arturo182/sama5d27c_breakout/(threads)

Thread 1 (2019-03-03):

USBC UFP termination resistors

limpkin, 2019-03-03:
Hello and congrats for the nice job!

Looking at https://community.cypress.com/docs/DOC-10779 it seems your 5.1k should be attached to GND and not +3.3V, do you agree?

arturo182, 2019-03-07:
Yes, I had it wrong all this time :D

Since the board is sinking current, the pulls should be connected to GND.

Good catch!

limpkin, 2019-03-07:
thanks for the footprint!
