arturo182/sama5d27c_breakout/sama5d27c_breakout.pdf

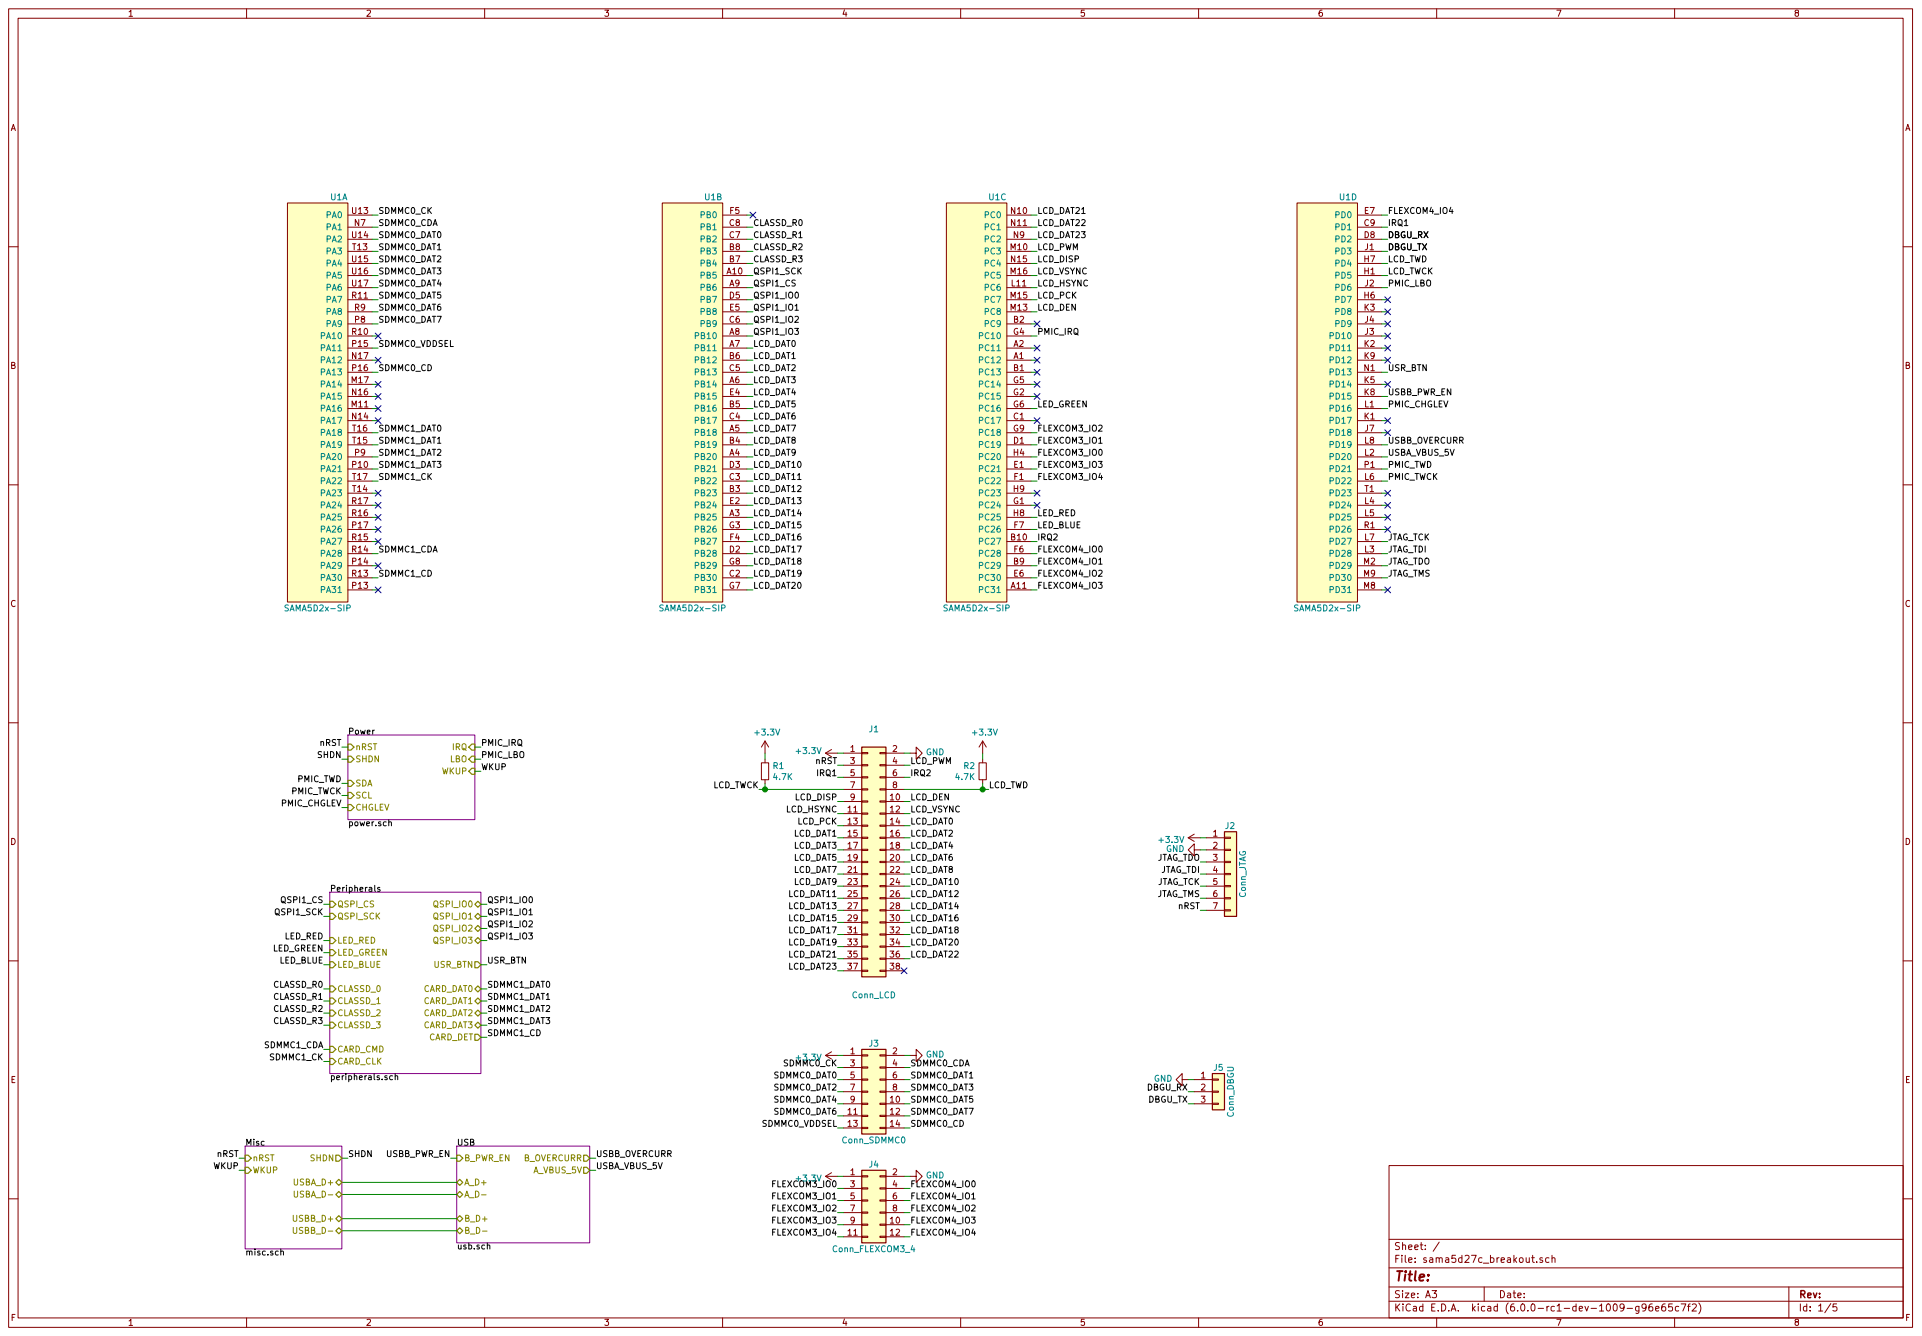
[picture p1: page 1]

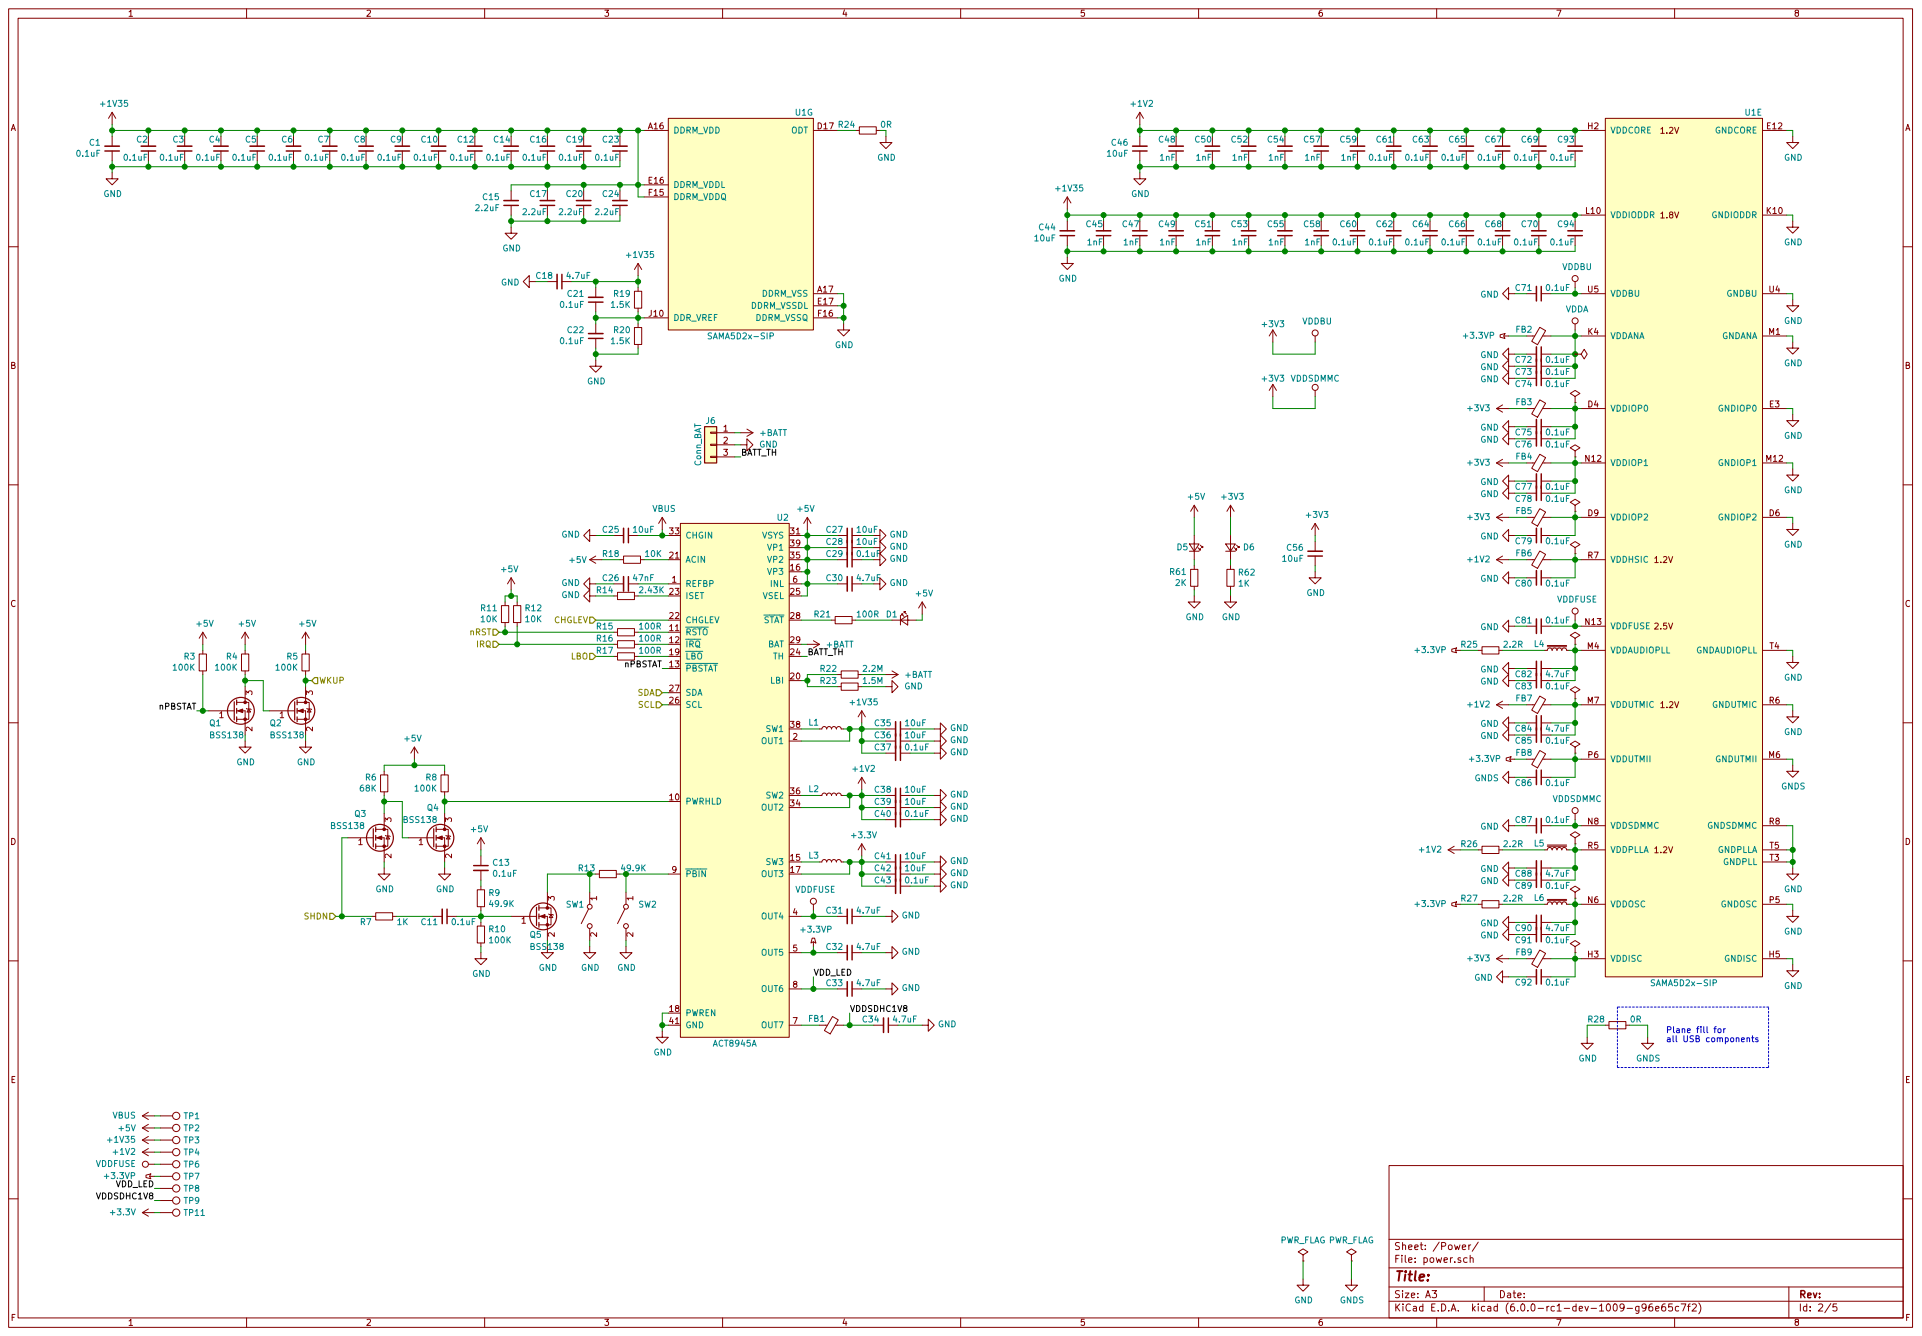
[picture p2: page 2]

Plane fill for all USB components

File: power.sch Sheet: /Power/

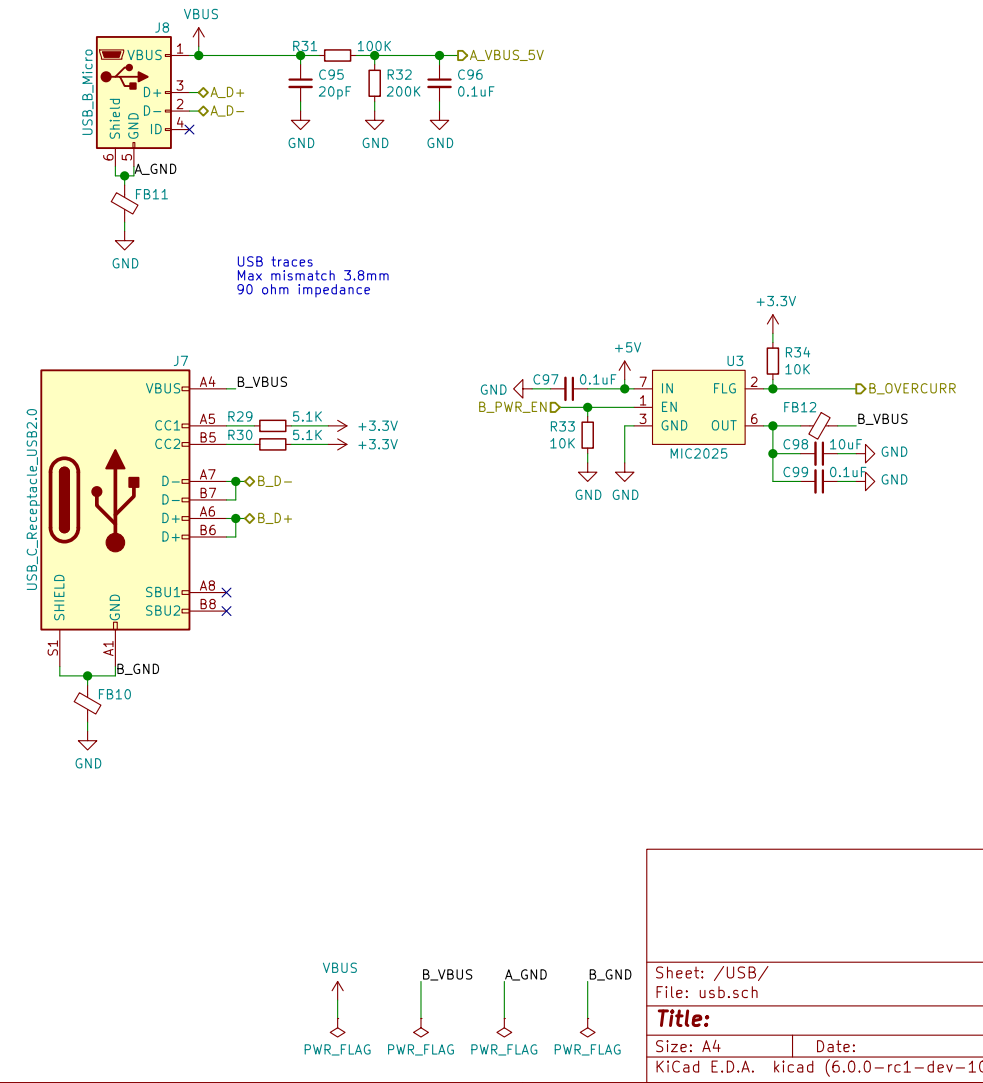
[picture p3: page 3]

Id: 3/5 Title: File: usb.sch Sheet: /USB/

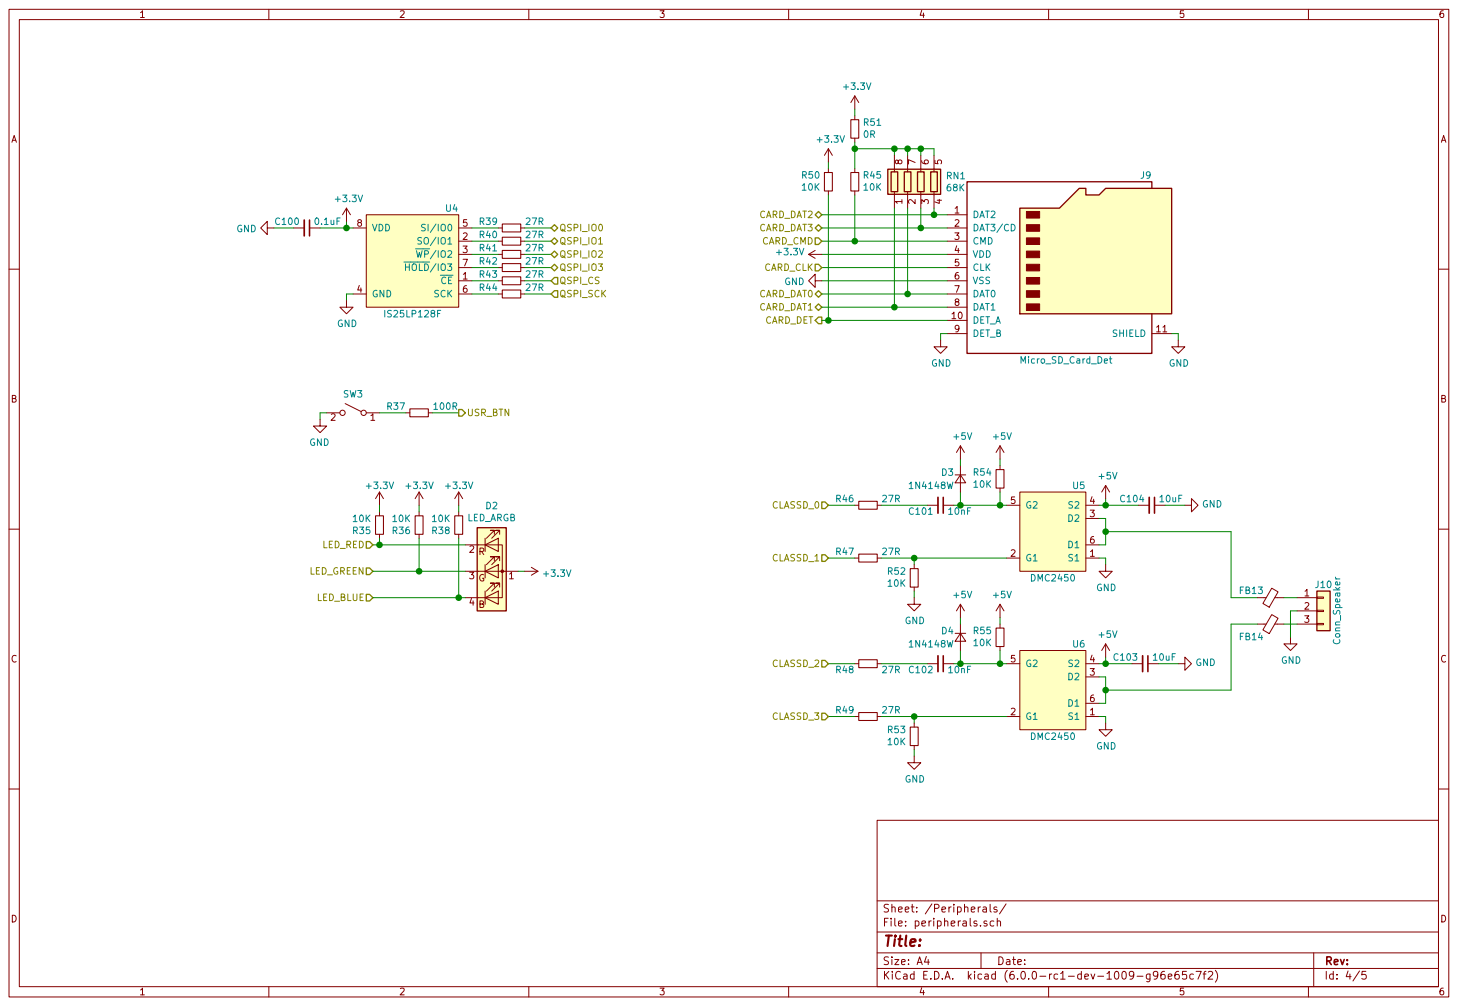
[picture p4: page 4]

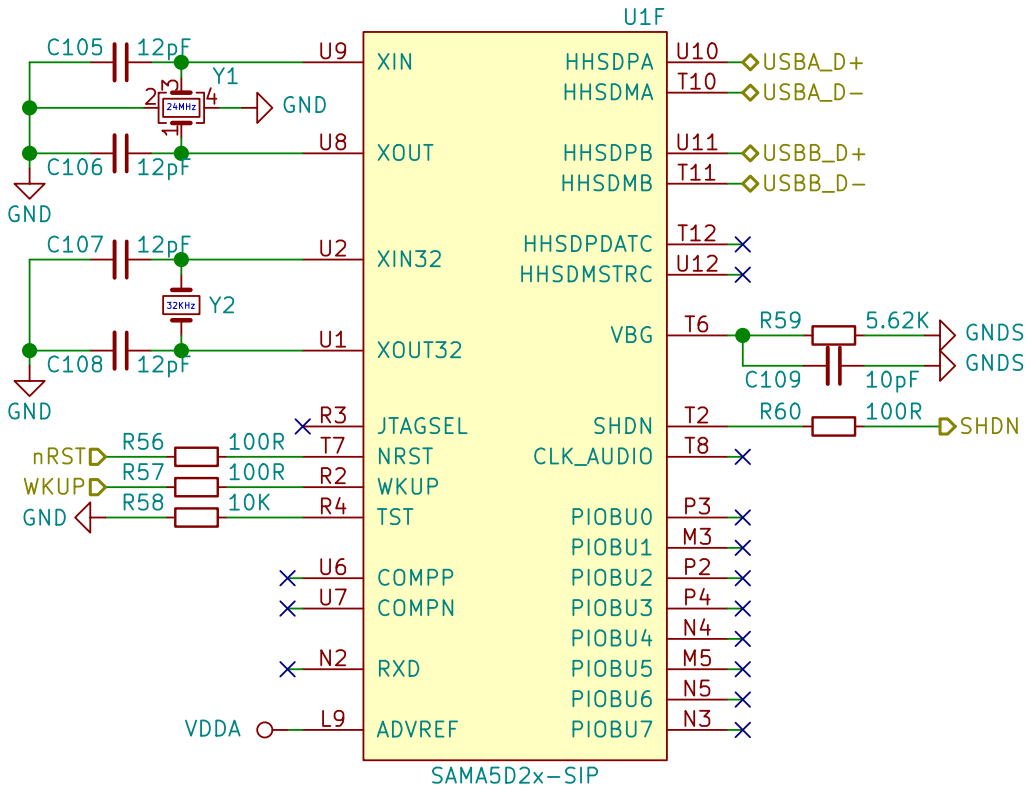
[picture p5: page 5]
