arturo182/sama5d27c_breakout/sama5d27c_breakout.kicad_pcb

## KiCad design sama5d27c_breakout.kicad_pcb (2018-12-05)

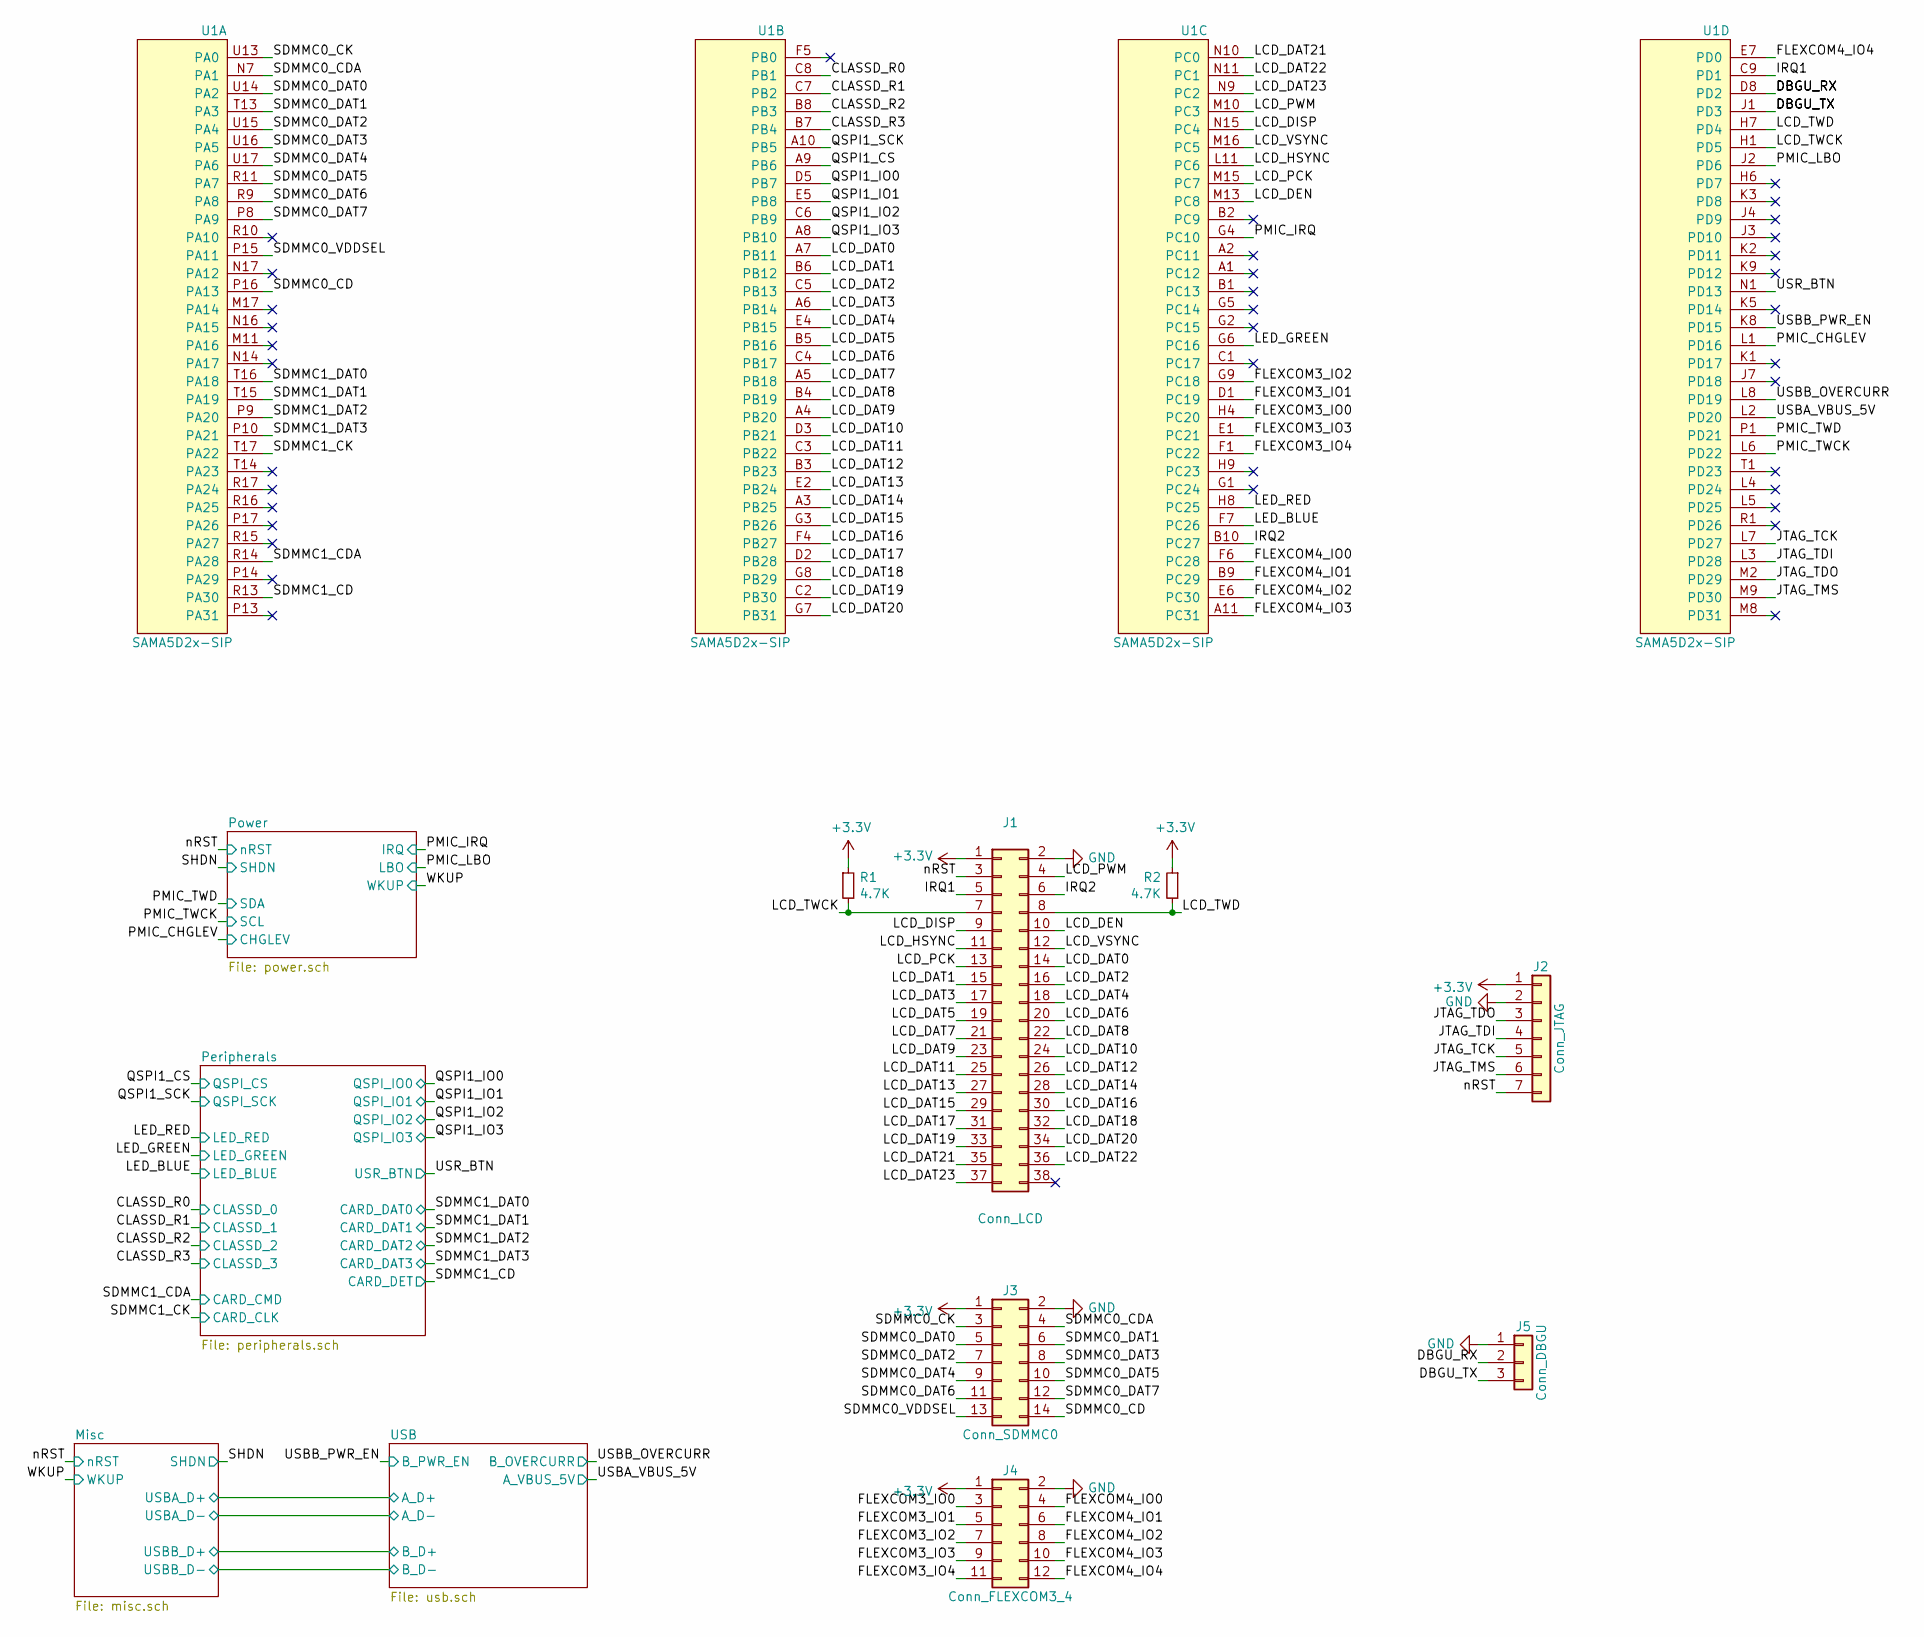
[picture p6: schematic sama5d27c_breakout.sch]

Parts:
J1: Conn_LCD; PinHeader_2x19_P1.27mm_Vertical_SMD
J2: Conn_JTAG; PinHeader_1x07_P2.54mm_Vertical
J3: Conn_SDMMC0; PinHeader_2x07_P2.54mm_Vertical
J4: Conn_FLEXCOM3_4; PinHeader_2x06_P2.54mm_Vertical
J5: Conn_DBGU; PinHeader_1x03_P2.54mm_Vertical
R1, R2: 4.7K; R_0603_1608Metric
U1: SAMA5D2x-SIP; TFBGA-289_17x17_14.0x14.0mm

Connections:
/CLASSD_R0: U1.C8 (PB1); also elsewhere on the board
/CLASSD_R1: U1.C7 (PB2); also elsewhere on the board
/CLASSD_R2: U1.B8 (PB3); also elsewhere on the board
/CLASSD_R3: U1.B7 (PB4); also elsewhere on the board
/DBGU_RX: J5.2, U1.D8 (PD2)
/DBGU_TX: J5.3, U1.J1 (PD3)
/FLEXCOM3_IO0: J4.3, U1.H4 (PC20)
/FLEXCOM3_IO1: J4.5, U1.D1 (PC19)
/FLEXCOM3_IO2: J4.7, U1.G9 (PC18)
/FLEXCOM3_IO3: J4.9, U1.E1 (PC21)
/FLEXCOM3_IO4: J4.11, U1.F1 (PC22)
/FLEXCOM4_IO0: J4.4, U1.F6 (PC28)
/FLEXCOM4_IO1: J4.6, U1.B9 (PC29)
/FLEXCOM4_IO2: J4.8, U1.E6 (PC30)
/FLEXCOM4_IO3: J4.10, U1.A11 (PC31)
/FLEXCOM4_IO4: J4.12, U1.E7 (PD0)
/IRQ1: J1.5, U1.C9 (PD1)
/IRQ2: J1.6, U1.B10 (PC27)
/JTAG_TCK: J2.5, U1.L7 (PD27)
/JTAG_TDI: J2.4, U1.L3 (PD28)
/JTAG_TDO: J2.3, U1.M2 (PD29)
/JTAG_TMS: J2.6, U1.M9 (PD30)
/LCD_DAT0: J1.14, U1.A7 (PB11)
/LCD_DAT1: J1.15, U1.B6 (PB12)
/LCD_DAT2: J1.16, U1.C5 (PB13)
/LCD_DAT3: J1.17, U1.A6 (PB14)
/LCD_DAT4: J1.18, U1.E4 (PB15)
/LCD_DAT5: J1.19, U1.B5 (PB16)
/LCD_DAT6: J1.20, U1.C4 (PB17)
/LCD_DAT7: J1.21, U1.A5 (PB18)
/LCD_DAT8: J1.22, U1.B4 (PB19)
/LCD_DAT9: J1.23, U1.A4 (PB20)
/LCD_DAT10: J1.24, U1.D3 (PB21)
/LCD_DAT11: J1.25, U1.C3 (PB22)
/LCD_DAT12: J1.26, U1.B3 (PB23)
/LCD_DAT13: J1.27, U1.E2 (PB24)
/LCD_DAT14: J1.28, U1.A3 (PB25)
/LCD_DAT15: J1.29, U1.G3 (PB26)
/LCD_DAT16: J1.30, U1.F4 (PB27)
/LCD_DAT17: J1.31, U1.D2 (PB28)
/LCD_DAT18: J1.32, U1.G8 (PB29)
/LCD_DAT19: J1.33, U1.C2 (PB30)
/LCD_DAT20: J1.34, U1.G7 (PB31)
/LCD_DAT21: J1.35, U1.N10 (PC0)
/LCD_DAT22: J1.36, U1.N11 (PC1)
/LCD_DAT23: J1.37, U1.N9 (PC2)
/LCD_DEN: J1.10, U1.M13 (PC8)
/LCD_DISP: J1.9, U1.N15 (PC4)
/LCD_HSYNC: J1.11, U1.L11 (PC6)
/LCD_PCK: J1.13, U1.M15 (PC7)
/LCD_PWM: J1.4, U1.M10 (PC3)
/LCD_TWCK: J1.7, R1.2, U1.H1 (PD5)
/LCD_TWD: J1.8, R2.2, U1.H7 (PD4)
/LCD_VSYNC: J1.12, U1.M16 (PC5)
/LED_BLUE: U1.F7 (PC26); also elsewhere on the board
/LED_GREEN: U1.G6 (PC16); also elsewhere on the board
/LED_RED: U1.H8 (PC25); also elsewhere on the board
/PMIC_CHGLEV: U1.L1 (PD16); also elsewhere on the board
/PMIC_IRQ: U1.G4 (PC10); also elsewhere on the board
/PMIC_LBO: U1.J2 (PD6); also elsewhere on the board
/PMIC_TWCK: U1.L6 (PD22); also elsewhere on the board
/PMIC_TWD: U1.P1 (PD21); also elsewhere on the board
/QSPI1_CS: U1.A9 (PB6); also elsewhere on the board
/QSPI1_IO0: U1.D5 (PB7); also elsewhere on the board
/QSPI1_IO1: U1.E5 (PB8); also elsewhere on the board
/QSPI1_IO2: U1.C6 (PB9); also elsewhere on the board
/QSPI1_IO3: U1.A8 (PB10); also elsewhere on the board
/QSPI1_SCK: U1.A10 (PB5); also elsewhere on the board
/SDMMC0_CD: J3.14, U1.P16 (PA13)
/SDMMC0_CDA: J3.4, U1.N7 (PA1)
/SDMMC0_CK: J3.3, U1.U13 (PA0)
/SDMMC0_DAT0: J3.5, U1.U14 (PA2)
/SDMMC0_DAT1: J3.6, U1.T13 (PA3)
/SDMMC0_DAT2: J3.7, U1.U15 (PA4)
/SDMMC0_DAT3: J3.8, U1.U16 (PA5)
/SDMMC0_DAT4: J3.9, U1.U17 (PA6)
/SDMMC0_DAT5: J3.10, U1.R11 (PA7)
/SDMMC0_DAT6: J3.11, U1.R9 (PA8)
/SDMMC0_DAT7: J3.12, U1.P8 (PA9)
/SDMMC0_VDDSEL: J3.13, U1.P15 (PA11)
/SDMMC1_CD: U1.R13 (PA30); also elsewhere on the board
/SDMMC1_CDA: U1.R14 (PA28); also elsewhere on the board
/SDMMC1_CK: U1.T17 (PA22); also elsewhere on the board
/SDMMC1_DAT0: U1.T16 (PA18); also elsewhere on the board
/SDMMC1_DAT1: U1.T15 (PA19); also elsewhere on the board
/SDMMC1_DAT2: U1.P9 (PA20); also elsewhere on the board
/SDMMC1_DAT3: U1.P10 (PA21); also elsewhere on the board
/USBA_VBUS_5V: U1.L2 (PD20); also elsewhere on the board
/USBB_OVERCURR: U1.L8 (PD19); also elsewhere on the board
/USBB_PWR_EN: U1.K8 (PD15); also elsewhere on the board
/USR_BTN: U1.N1 (PD13); also elsewhere on the board
/nRST: J1.3, J2.7; also elsewhere on the board
GND: J1.2, J2.2, J3.2, J4.2, J5.1; also elsewhere on the board

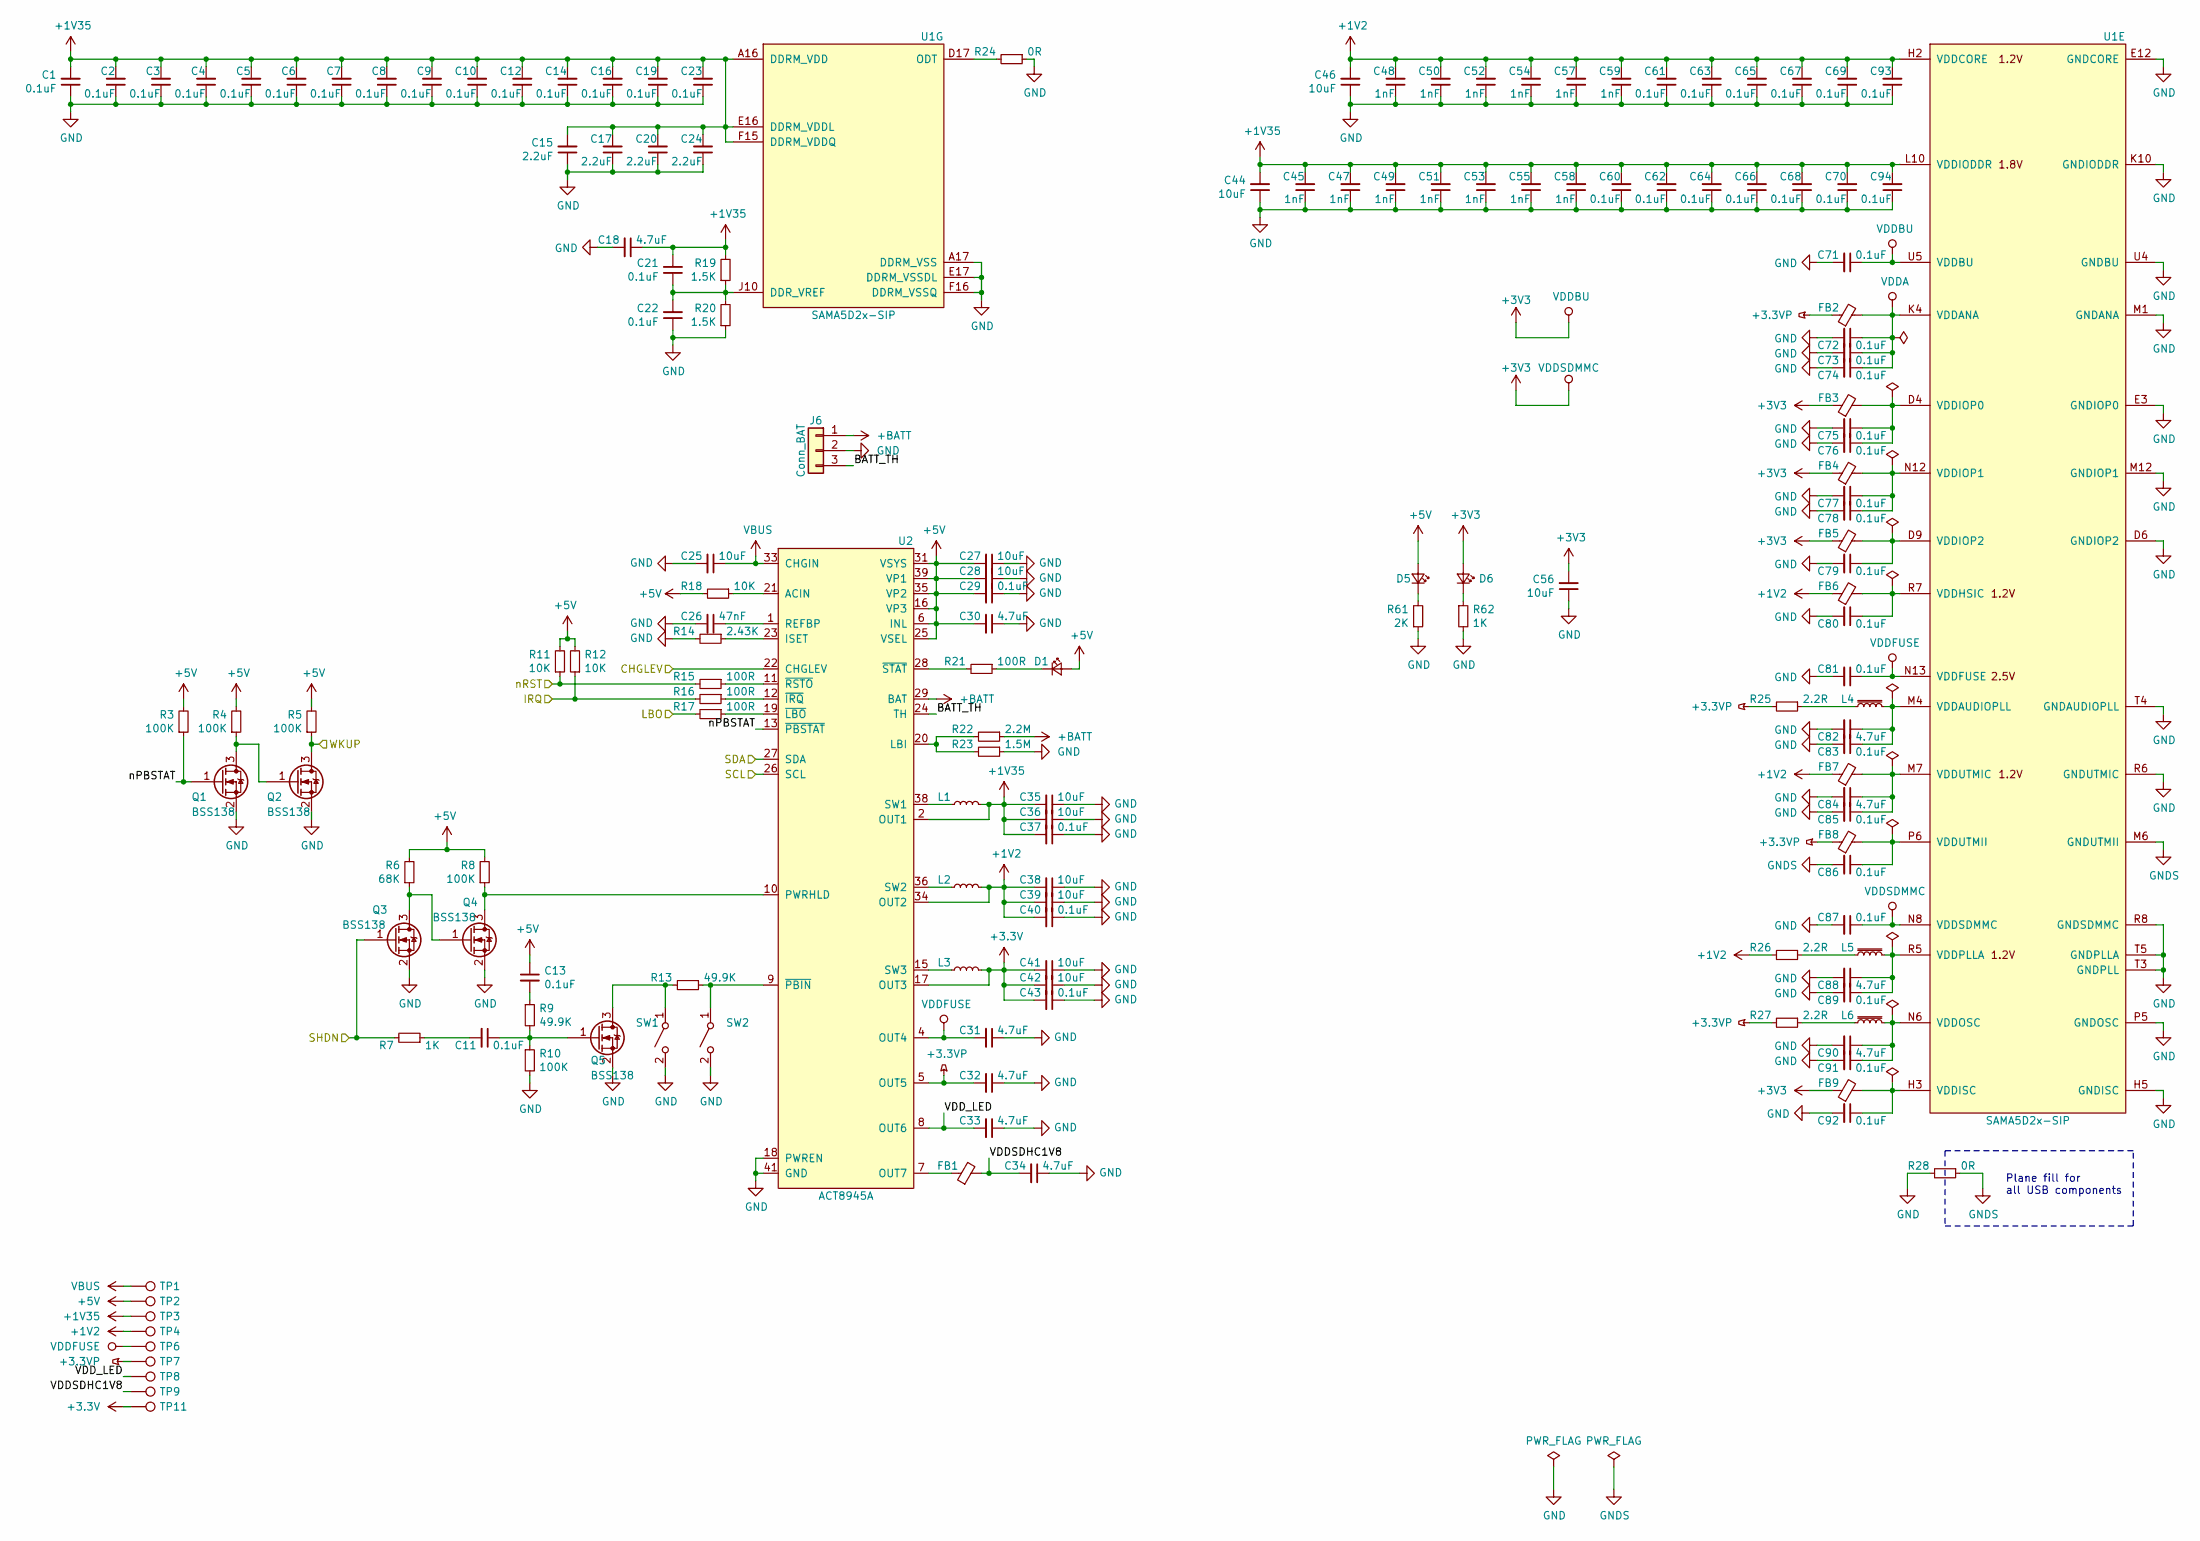
[picture p7: schematic power.sch]

Parts:
C1, C2, C3, C4, C5, C6, C7, C8, C9, C10, C11, C12, C13, C14, C16, C19, C21, C22, C23, C29, C37, C40, C43, C60, C61, C62, C63, C64, C65, C66, C67, C68, C69, C70, C71, C72, C73, C74, C75, C76, C77, C78, C79, C80, C81, C83, C85, C86, C87, C89, C91, C92, C93, C94: 0.1uF; C_0402_1005Metric
C15, C17, C20, C24: 2.2uF; C_0402_1005Metric
C18, C30, C31, C32, C33, C34, C82, C84, C88, C90: 4.7uF; C_0402_1005Metric
C25, C27, C28, C35, C36, C38, C39, C41, C42, C44, C46, C56: 10uF; C_0402_1005Metric
C26: 47nF; C_0402_1005Metric
C45, C47, C48, C49, C50, C51, C52, C53, C54, C55, C57, C58, C59: 1nF; C_0402_1005Metric
D1: LED_CHARGE; LED_0603_1608Metric
D5: LED_5V; LED_0603_1608Metric
D6: LED_3V; LED_0603_1608Metric
FB1: BLM18PG181SN1D; L_0603_1608Metric
FB2, FB3, FB4, FB5, FB6, FB7, FB8, FB9: BLM18PG300SN1D; L_0603_1608Metric
J6: Conn_BAT; PinHeader_1x03_P2.54mm_Vertical
L1, L2, L3: LQM2HPN2R2MG0L; L_Taiyo-Yuden_MD-3030
L4, L5, L6: MLZ1608N100L; L_0603_1608Metric
Q1, Q2, Q3, Q4, Q5: BSS138; SOT-23
R3, R4, R5, R8, R10: 100K; R_0603_1608Metric
R6: 68K; R_0603_1608Metric
R7, R62: 1K; R_0603_1608Metric
R9, R13: 49.9K; R_0603_1608Metric
R11, R12, R18: 10K; R_0603_1608Metric
R14: 2.43K; R_0603_1608Metric
R15, R16, R17, R21: 100R; R_0603_1608Metric
R19, R20: 1.5K; R_0603_1608Metric
R22: 2.2M; R_0603_1608Metric
R23: 1.5M; R_0603_1608Metric
R24, R28: 0R; R_0603_1608Metric
R25, R26, R27: 2.2R; R_0603_1608Metric
R61: 2K; R_0603_1608Metric
SW1: SW_WAKEUP; SW_SPST_FSMSM
SW2: SW_RESET; SW_SPST_FSMSM
TP1: TP_VBUS; TestPoint_Pad_D1.5mm
TP2: TP_5V; TestPoint_Pad_D1.5mm
TP3: TP_1.35V; TestPoint_Pad_D1.5mm
TP4: TP_1.2V; TestPoint_Pad_D1.5mm
TP6: TP_VDDFUSE; TestPoint_Pad_D1.5mm
TP7: TP_3.3VP; TestPoint_Pad_D1.5mm
TP8: TP_VDD_LED; TestPoint_Pad_D1.5mm
TP9: TP_VDDSDHC1V8; TestPoint_Pad_D1.5mm
TP11: TP_VDDSDMMC; TestPoint_Pad_D1.5mm
U1: SAMA5D2x-SIP; TFBGA-289_17x17_14.0x14.0mm
U2: ACT8945A; QFN-40-1EP_5x5mm_P0.4mm_EP3.6x3.6mm

Connections:
+1V2: C38.2, C39.2, C40.2, C46.2, C48.2, C50.2, C52.2, C54.2, C57.2, C59.2, C61.2, C63.2, C65.2, C67.2, C69.2, C93.2, FB6.1, FB7.1, L2.1, R26.2, TP4.1, U1.D7 (VDDCORE), U1.E9 (VDDCORE), U1.H2 (VDDCORE), U1.L12 (VDDCORE), U1.P7 (VDDCORE), U1.U3 (VDDCORE), U2.34 (OUT2)
+1V35: C1.2, C2.2, C3.2, C4.2, C5.2, C6.2, C7.2, C8.2, C9.2, C10.2, C12.2, C14.2, C15.2, C16.2, C17.2, C18.1, C19.2, C20.2, C21.2, C23.2, C24.2, C35.2, C36.2, C37.2, C44.2, C45.2, C47.2, C49.2, C51.2, C53.2, C55.2, C58.2, C60.2, C62.2, C64.2, C66.2, C68.2, C70.2, C94.2, L1.1, R19.2, TP3.1, U1.A16 (DDRM_VDD), U1.B16 (DDRM_VDD), U1.C16 (DDRM_VDD), U1.D16 (DDRM_VDD), U1.E8 (VDDIODDR), U1.E11 (VDDIODDR), U1.E15 (DDRM_VDD), U1.E16 (DDRM_VDDL), U1.F15 (DDRM_VDDQ), U1.G12 (VDDIODDR), U1.G15 (DDRM_VDDQ), U1.G17 (DDRM_VDD), U1.H10 (VDDIODDR), U1.H15 (DDRM_VDDQ), U1.J8 (VDDIODDR), U1.J15 (DDRM_VDDQ), U1.J17 (DDRM_VDD), U1.K15 (DDRM_VDDQ), U1.L10 (VDDIODDR), U1.L14 (VDDIODDR), U1.L15 (DDRM_VDDQ), U1.L16 (DDRM_VDD), U2.2 (OUT1)
+3.3VP: C32.2, FB2.1, FB8.1, R25.2, R27.2, TP7.1, U2.5 (OUT5)
+5V: C13.1, C27.2, C28.2, C29.2, C30.2, D1.2 (A), D5.2 (A), R3.2, R4.2, R5.2, R6.2, R8.2, R11.2, R12.2, R18.2, TP2.1, U2.6 (INL), U2.16 (VP3), U2.25 (VSEL), U2.31 (VSYS), U2.32 (VSYS), U2.35 (VP2), U2.39 (VP1); also elsewhere on the board
+BATT: J6.1, R22.1, U2.29 (BAT), U2.30 (BAT)
/PMIC_CHGLEV: U2.22 (CHGLEV); also elsewhere on the board
/PMIC_IRQ: R12.1, R16.2; also elsewhere on the board
/PMIC_LBO: R17.2; also elsewhere on the board
/PMIC_TWCK: U2.26 (SCL); also elsewhere on the board
/PMIC_TWD: U2.27 (SDA); also elsewhere on the board
/Power/BATT_TH: J6.3, U2.24 (TH)
/Power/VDDSDHC1V8: C34.2, FB1.2, TP9.1
/Power/VDD_LED: C33.2, TP8.1, U2.8 (OUT6)
/Power/nPBSTAT: Q1.1 (G), R3.1, U2.13 (~PBSTAT~)
/SHDN: Q3.1 (G), R7.2; also elsewhere on the board
/WKUP: Q2.3 (D), R5.1; also elsewhere on the board
/nRST: R11.1, R15.2; also elsewhere on the board
GND: C1.1, C2.1, C3.1, C4.1, C5.1, C6.1, C7.1, C8.1, C9.1, C10.1, C12.1, C14.1, C15.1, C16.1, C17.1, C18.2, C19.1, C20.1, C22.1, C23.1, C24.1, C25.2, C26.2, C27.1, C28.1, C29.1, C30.1, C31.1, C32.1, C33.1, C34.1, C35.1, C36.1, C37.1, C38.1, C39.1, C40.1, C41.1, C42.1, C43.1, C44.1, C45.1, C46.1, C47.1, C48.1, C49.1, C50.1, C51.1, C52.1, C53.1, C54.1, C55.1, C56.1, C57.1, C58.1, C59.1, C60.1, C61.1, C62.1, C63.1, C64.1, C65.1, C66.1, C67.1, C68.1, C69.1, C70.1, C71.2, C72.2, C73.2, C74.2, C75.2, C76.2, C77.2, C78.2, C79.2, C80.2, C81.2, C82.2, C83.2, C84.2, C85.2, C87.2, C88.2, C89.2, C90.2, C91.2, C92.2, C93.1, C94.1, J6.2, Q1.2 (S), Q2.2 (S), Q3.2 (S), Q4.2 (S), Q5.2 (S), R10.2, R14.2, R20.1, R23.1, R24.1, R28.2, R61.1, R62.2, SW1.2 (B), SW2.2 (B), U1.A17 (DDRM_VSS), U1.B17 (DDRM_VSS), U1.C17 (DDRM_VSS), U1.D6 (GNDIOP2), U1.D15 (DDRM_VSS), U1.E3 (GNDIOP0), U1.E10 (GNDIODDR), U1.E12 (GNDCORE), U1.E14 (DDRM_VSS), U1.E17 (DDRM_VSSDL), U1.F2 (GNDIOP0), U1.F8 (GNDIODDR), U1.F12 (GNDCORE), U1.F16 (DDRM_VSSQ), U1.F17 (DDRM_VSS), U1.G10 (GNDIODDR), U1.G16 (DDRM_VSSQ), U1.H5 (GNDISC), U1.H12 (GNDIODDR), U1.H16 (DDRM_VSSQ), U1.H17 (DDRM_VSS), U1.J6 (GNDANA), U1.J9 (GNDIODDR), U1.J11 (GNDCORE), U1.J16 (DDRM_VSSQ), U1.K6 (GNDCORE), U1.K7 (GNDCORE), U1.K10 (GNDIODDR), U1.K11 (GNDCORE), U1.K16 (DDRM_VSSQ), U1.K17 (DDRM_VSSQ), U1.L17 (DDRM_VSS), U1.M1 (GNDANA), U1.M12 (GNDIOP1), U1.M14 (GNDIODDR), U1.P5 (GNDOSC), U1.P11 (GNDIOP1), U1.R6 (GNDUTMIC), U1.R8 (GNDSDMMC), U1.T3 (GNDPLL), U1.T4 (GNDAUDIOPLL), U1.T5 (GNDPLLA), U1.U4 (GNDBU), U2.3 (GA), U2.14 (GP3), U2.18 (PWREN), U2.37 (GP12), U2.41 (GND); also elsewhere on the board
GNDS: C86.2, R28.1, U1.M6 (GNDUTMII); also elsewhere on the board
unnamed: C11.1, Q5.1 (G), R9.2, R10.1
unnamed: C11.2, R7.1
unnamed: C13.2, R9.1
unnamed: C21.1, C22.2, R19.1, R20.2, U1.F11 (DDR_VREF), U1.J10 (DDR_VREF)
unnamed: C26.1, U2.1 (REFBP)
unnamed: C75.1, C76.1, FB3.2, U1.D4 (VDDIOP0), U1.F3 (VDDIOP0)
unnamed: C77.1, C78.1, FB4.2, U1.N12 (VDDIOP1), U1.P12 (VDDIOP1)
unnamed: C79.1, FB5.2, U1.D9 (VDDIOP2)
unnamed: C80.1, FB6.2, U1.R7 (VDDHSIC)
unnamed: C82.1, C83.1, L4.2, U1.M4 (VDDAUDIOPLL)
unnamed: C84.1, C85.1, FB7.2, U1.M7 (VDDUTMIC)
unnamed: C86.1, FB8.2, U1.P6 (VDDUTMII)
unnamed: C88.1, C89.1, L5.2, U1.R5 (VDDPLLA)
unnamed: C90.1, C91.1, L6.2, U1.N6 (VDDOSC)
unnamed: C92.1, FB9.2, U1.H3 (VDDISC)
unnamed: D1.1 (K), R21.1
unnamed: D5.1 (K), R61.2
unnamed: D6.1 (K), R62.1
unnamed: FB1.1, U2.7 (OUT7)
unnamed: L1.2, U2.38 (SW1)
unnamed: L2.2, U2.36 (SW2)
unnamed: L3.2, U2.15 (SW3)
unnamed: L4.1, R25.1
unnamed: L5.1, R26.1
unnamed: L6.1, R27.1
unnamed: Q1.3 (D), Q2.1 (G), R4.1
unnamed: Q3.3 (D), Q4.1 (G), R6.1
unnamed: Q4.3 (D), R8.1, U2.10 (PWRHLD)
unnamed: Q5.3 (D), R13.2, SW1.1 (A)
unnamed: R13.1, SW2.1 (A), U2.9 (~PBIN~)
unnamed: R14.1, U2.23 (ISET)
unnamed: R15.1, U2.11 (~RSTO~)
unnamed: R16.1, U2.12 (~IRQ~)
unnamed: R17.1, U2.19 (~LBO~)
unnamed: R18.1, U2.21 (ACIN)
unnamed: R21.2, U2.28 (~STAT~)
unnamed: R22.2, R23.2, U2.20 (LBI)
unnamed: R24.2, U1.D17 (ODT)
VBUS: C25.1, TP1.1, U2.33 (CHGIN); also elsewhere on the board
VDDA: C72.1, C73.1, C74.1, FB2.2, U1.J5 (VDDANA), U1.K4 (VDDANA); also elsewhere on the board
VDDFUSE: C31.2, C81.1, TP6.1, U1.N13 (VDDFUSE), U2.4 (OUT4)

Notes on the sheet:
Plane fill for all USB components

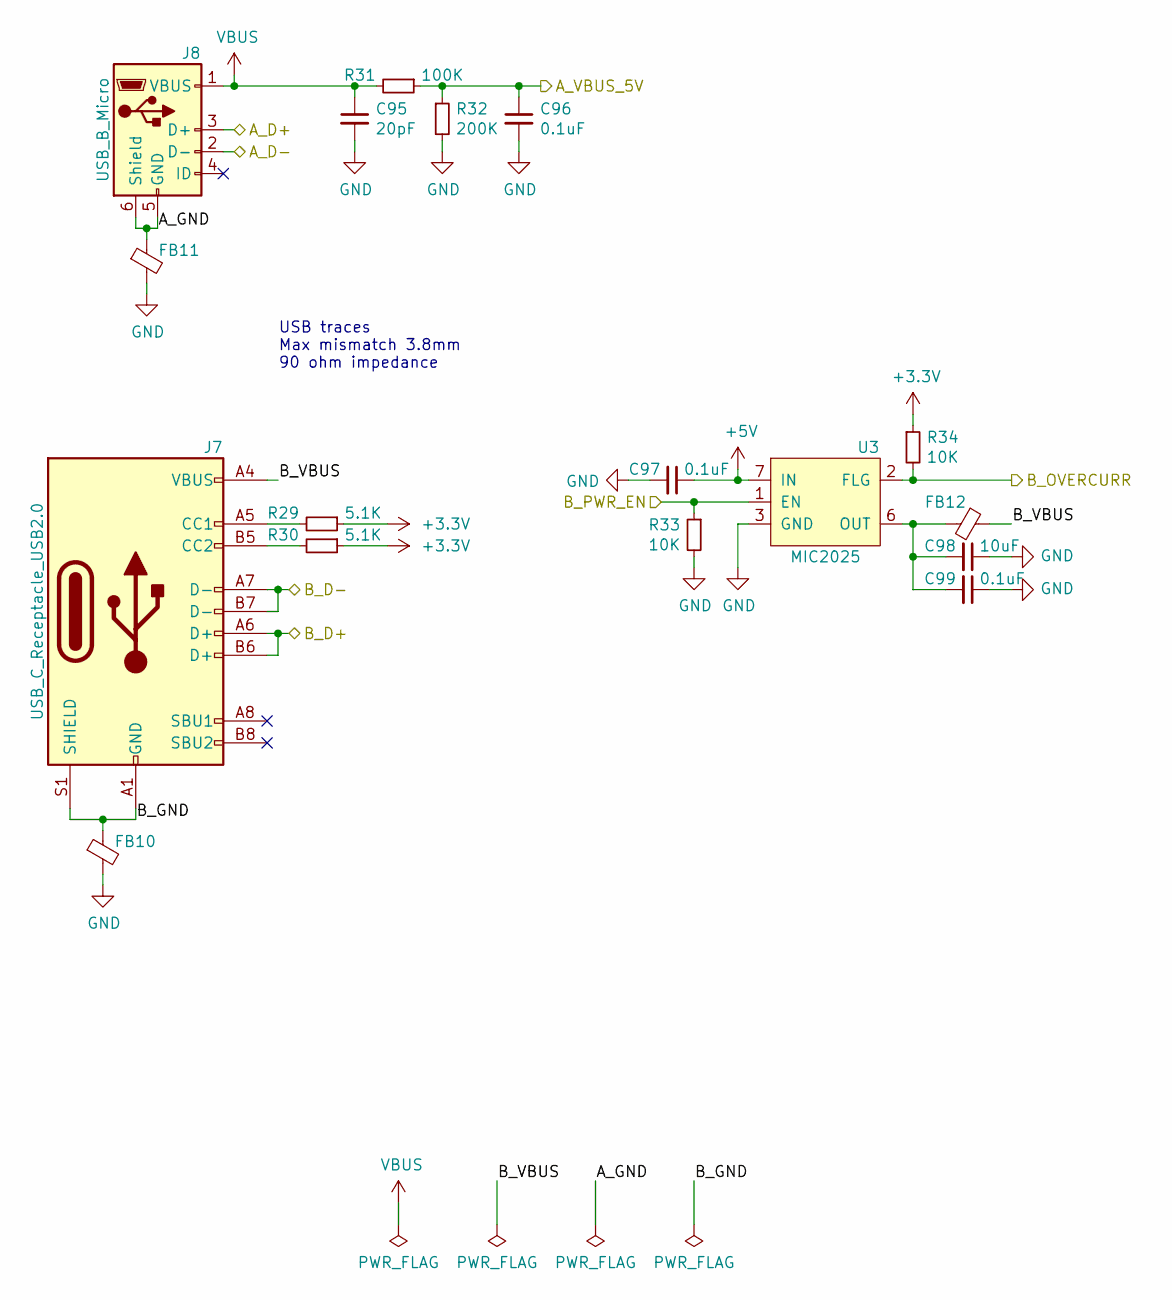
[picture p8: schematic usb.sch]

Parts:
C95: 20pF; C_0402_1005Metric
C96, C97, C99: 0.1uF; C_0402_1005Metric
C98: 10uF; C_0402_1005Metric
FB10, FB11, FB12: BLM18PG300SN1D; L_0603_1608Metric
J7: USB_C_Receptacle_USB2.0; USB_C_Receptacle_GT-USB-7010
J8: USB_B_Micro; USB_Micro-B_Molex-105017-0001
R29, R30: 5.1K; R_0603_1608Metric
R31: 100K; R_0603_1608Metric
R32: 200K; R_0603_1608Metric
R33, R34: 10K; R_0603_1608Metric
U3: MIC2025; SOIC-8_3.9x4.9mm_P1.27mm

Connections:
+5V: C97.1, U3.7 (IN); also elsewhere on the board
/USB/A_D+: J8.3 (D+); also elsewhere on the board
/USB/A_D-: J8.2 (D-); also elsewhere on the board
/USB/A_GND: FB11.1, J8.5 (GND), J8.6 (Shield)
/USB/B_D+: J7.A6 (D+), J7.B6 (D+); also elsewhere on the board
/USB/B_D-: J7.A7 (D-), J7.B7 (D-); also elsewhere on the board
/USB/B_GND: FB10.1, J7.A1 (GND), J7.A12 (GND), J7.B1 (GND), J7.B12 (GND), J7.S1 (SHIELD)
/USB/B_VBUS: FB12.1, J7.A4 (VBUS), J7.A9 (VBUS), J7.B4 (VBUS), J7.B9 (VBUS)
/USBA_VBUS_5V: C96.1, R31.1, R32.1; also elsewhere on the board
/USBB_OVERCURR: R34.2, U3.2 (FLG); also elsewhere on the board
/USBB_PWR_EN: R33.1, U3.1 (EN); also elsewhere on the board
GND: C95.2, C96.2, C97.2, C98.1, C99.1, FB10.2, FB11.2, R32.2, R33.2, U3.3 (GND); also elsewhere on the board
unnamed: C98.2, C99.2, FB12.2, U3.6 (OUT), U3.8 (OUT)
unnamed: J7.A5 (CC1), R29.2
unnamed: J7.B5 (CC2), R30.2
VBUS: C95.1, J8.1 (VBUS), R31.2; also elsewhere on the board

Notes on the sheet:
USB traces Max mismatch 3.8mm 90 ohm impedance

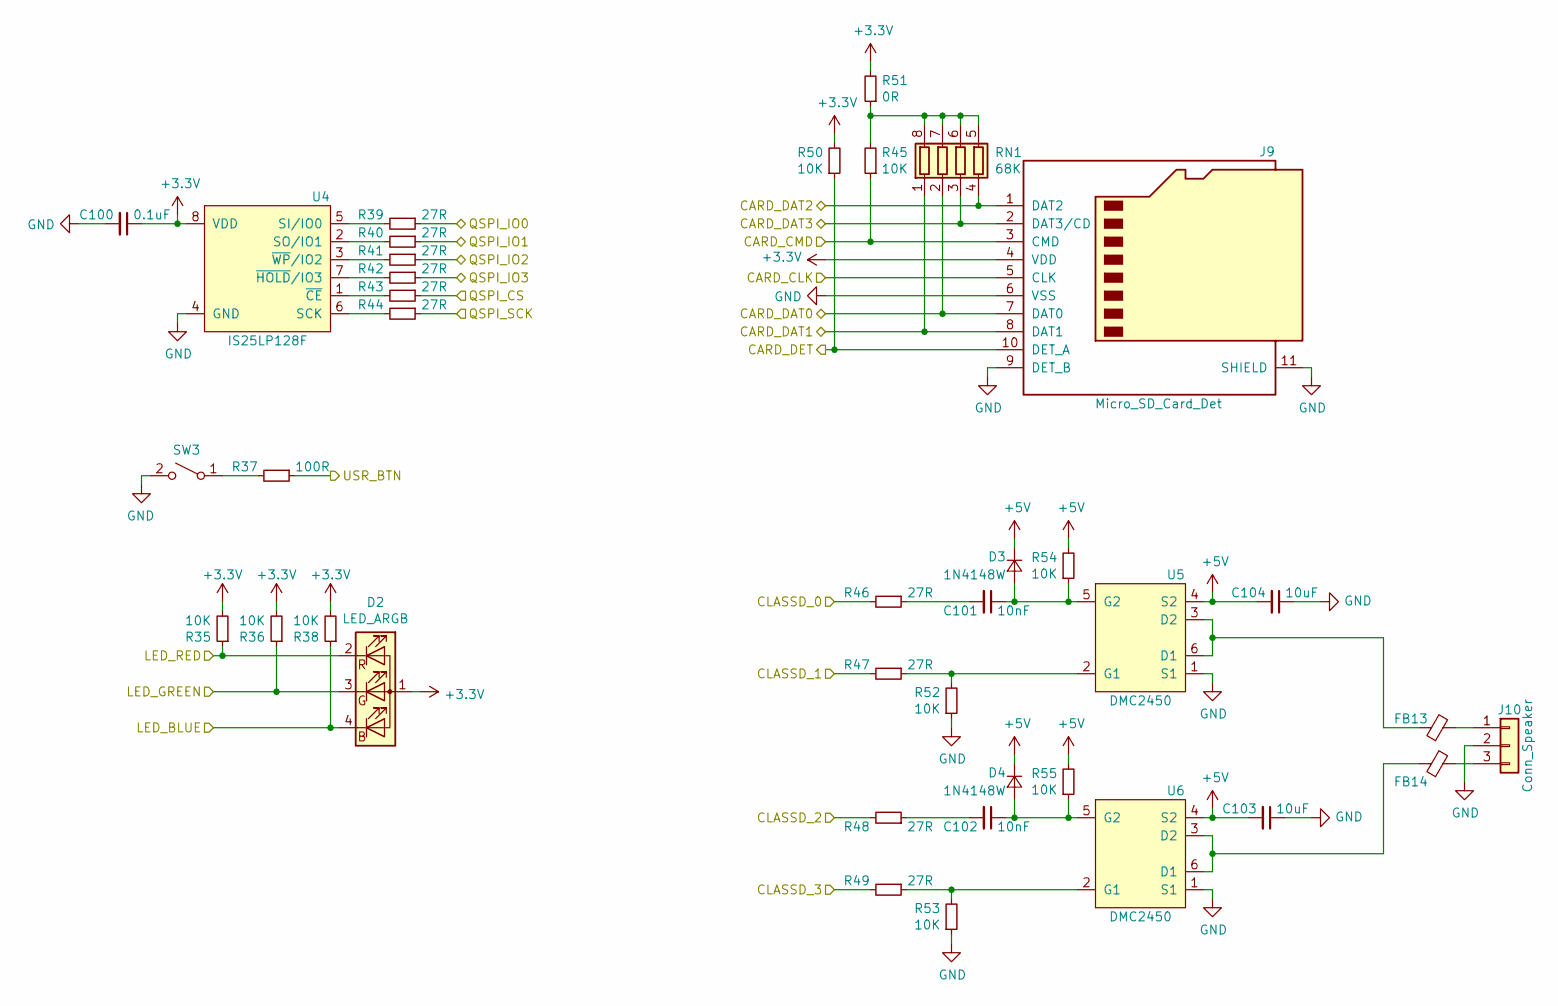
[picture p9: schematic peripherals.sch]

Parts:
C100: 0.1uF; C_0402_1005Metric
C101, C102: 10nF; C_0402_1005Metric
C103, C104: 10uF; C_0402_1005Metric
D2: LED_ARGB; LED_RGB_0606_1616Metric
D3, D4: 1N4148W; D_SOD-123
FB13, FB14: BLM18PG300SN1D; L_0603_1608Metric
J9: Micro_SD_Card_Det; microSD_HC_Molex_104031-0811
J10: Conn_Speaker; PinHeader_1x03_P2.54mm_Vertical
R35, R36, R38, R45, R50, R52, R53, R54, R55: 10K; R_0603_1608Metric
R37: 100R; R_0603_1608Metric
R39, R40, R41, R42, R43, R44, R46, R47, R48, R49: 27R; R_0603_1608Metric
R51: 0R; R_0603_1608Metric
RN1: 68K; R_Array_Concave_4x0603
SW3: SW_USR; SW_SPST_FSMSM
U4: IS25LP128F; WSON-8-1EP_6x5mm_P1.27mm_EP3.4x4mm
U5, U6: DMC2450; SOT-563

Connections:
+5V: C103.2, C104.2, D3.1 (K), D4.1 (K), R54.2, R55.2, U5.4 (S2), U6.4 (S2); also elsewhere on the board
/CLASSD_R0: R46.2; also elsewhere on the board
/CLASSD_R1: R47.2; also elsewhere on the board
/CLASSD_R2: R48.2; also elsewhere on the board
/CLASSD_R3: R49.2; also elsewhere on the board
/LED_BLUE: D2.4 (BK), R38.1; also elsewhere on the board
/LED_GREEN: D2.3 (GK), R36.1; also elsewhere on the board
/LED_RED: D2.2 (RK), R35.1; also elsewhere on the board
/QSPI1_CS: R43.1; also elsewhere on the board
/QSPI1_IO0: R39.1; also elsewhere on the board
/QSPI1_IO1: R40.1; also elsewhere on the board
/QSPI1_IO2: R41.1; also elsewhere on the board
/QSPI1_IO3: R42.1; also elsewhere on the board
/QSPI1_SCK: R44.1; also elsewhere on the board
/SDMMC1_CD: J9.10 (DET_A), R50.1; also elsewhere on the board
/SDMMC1_CDA: J9.3 (CMD), R45.1; also elsewhere on the board
/SDMMC1_CK: J9.5 (CLK); also elsewhere on the board
/SDMMC1_DAT0: J9.7 (DAT0), RN1.2 (R2.1); also elsewhere on the board
/SDMMC1_DAT1: J9.8 (DAT1), RN1.1 (R1.1); also elsewhere on the board
/SDMMC1_DAT2: J9.1 (DAT2), RN1.4 (R4.1); also elsewhere on the board
/SDMMC1_DAT3: J9.2 (DAT3/CD), RN1.3 (R3.1); also elsewhere on the board
/USR_BTN: R37.1; also elsewhere on the board
GND: C100.2, C103.1, C104.1, J9.6 (VSS), J9.9 (DET_B), J9.11 (SHIELD), J10.2, R52.1, R53.1, SW3.2 (B), U4.4 (GND), U4.9 (GND), U5.1 (S1), U6.1 (S1); also elsewhere on the board
unnamed: C101.1, D3.2 (A), R54.1, U5.5 (G2)
unnamed: C101.2, R46.1
unnamed: C102.1, D4.2 (A), R55.1, U6.5 (G2)
unnamed: C102.2, R48.1
unnamed: FB13.1, U5.3 (D2), U5.6 (D1)
unnamed: FB13.2, J10.1
unnamed: FB14.1, U6.3 (D2), U6.6 (D1)
unnamed: FB14.2, J10.3
unnamed: R37.2, SW3.1 (A)
unnamed: R39.2, U4.5 (SI/IO0)
unnamed: R40.2, U4.2 (SO/IO1)
unnamed: R41.2, U4.3 (~WP~/IO2)
unnamed: R42.2, U4.7 (~HOLD~/IO3)
unnamed: R43.2, U4.1 (~CE~)
unnamed: R44.2, U4.6 (SCK)
unnamed: R45.2, R51.1, RN1.5 (R4.2), RN1.6 (R3.2), RN1.7 (R2.2), RN1.8 (R1.2)
unnamed: R47.1, R52.2, U5.2 (G1)
unnamed: R49.1, R53.2, U6.2 (G1)

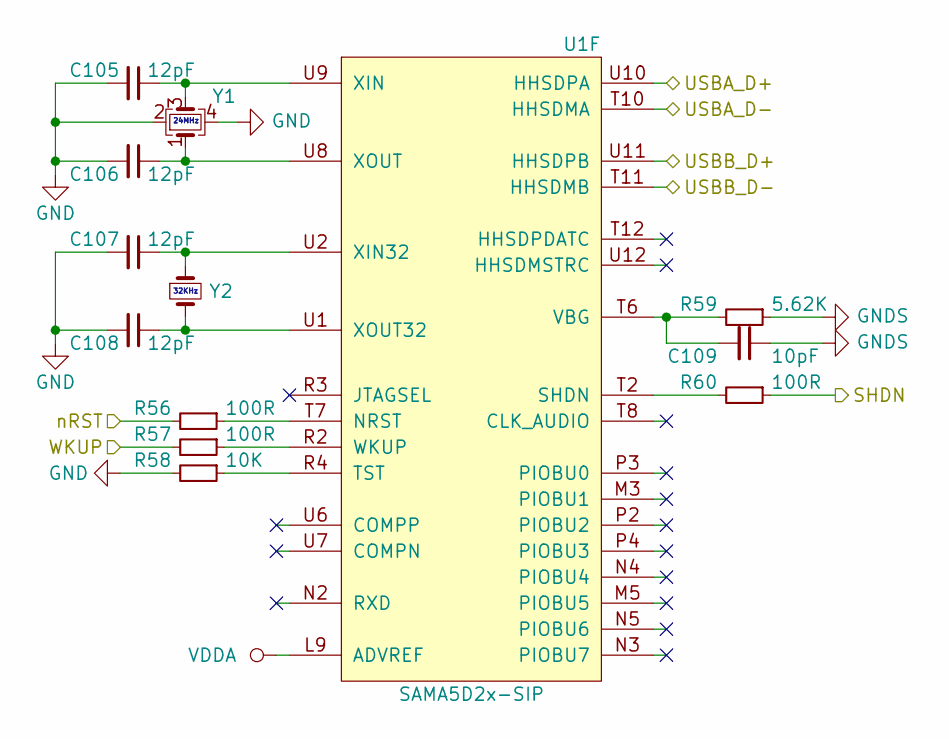
[picture p10: schematic misc.sch]

Parts:
C105, C106, C107, C108: 12pF; C_0402_1005Metric; Voltage 50V
C109: 10pF; C_0402_1005Metric
R56, R57, R60: 100R; R_0603_1608Metric
R58: 10K; R_0603_1608Metric
R59: 5.62K; R_0603_1608Metric
U1: SAMA5D2x-SIP; TFBGA-289_17x17_14.0x14.0mm
Y1: TSX-3225 24MHz; Crystal_SMD_3225-4Pin_3.2x2.5mm
Y2: 32kHz; Crystal_SMD_3215-2Pin_3.2x1.5mm

Connections:
/SHDN: R60.1; also elsewhere on the board
/USB/A_D+: U1.U10 (HHSDPA); also elsewhere on the board
/USB/A_D-: U1.T10 (HHSDMA); also elsewhere on the board
/USB/B_D+: U1.U11 (HHSDPB); also elsewhere on the board
/USB/B_D-: U1.T11 (HHSDMB); also elsewhere on the board
/WKUP: R57.2; also elsewhere on the board
/nRST: R56.2; also elsewhere on the board
GND: C105.2, C106.2, C107.2, C108.2, R58.2, Y1.2, Y1.4; also elsewhere on the board
GNDS: C109.1, R59.1; also elsewhere on the board
unnamed: C105.1, U1.U9 (XIN), Y1.3
unnamed: C106.1, U1.U8 (XOUT), Y1.1
unnamed: C107.1, U1.U2 (XIN32), Y2.1
unnamed: C108.1, U1.U1 (XOUT32), Y2.2
unnamed: C109.2, R59.2, U1.T6 (VBG)
unnamed: R56.1, U1.T7 (NRST)
unnamed: R57.1, U1.R2 (WKUP)
unnamed: R58.1, U1.R4 (TST)
unnamed: R60.2, U1.T2 (SHDN)
VDDA: U1.L9 (ADVREF); also elsewhere on the board

Notes on the sheet:
24MHz
32KHz

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
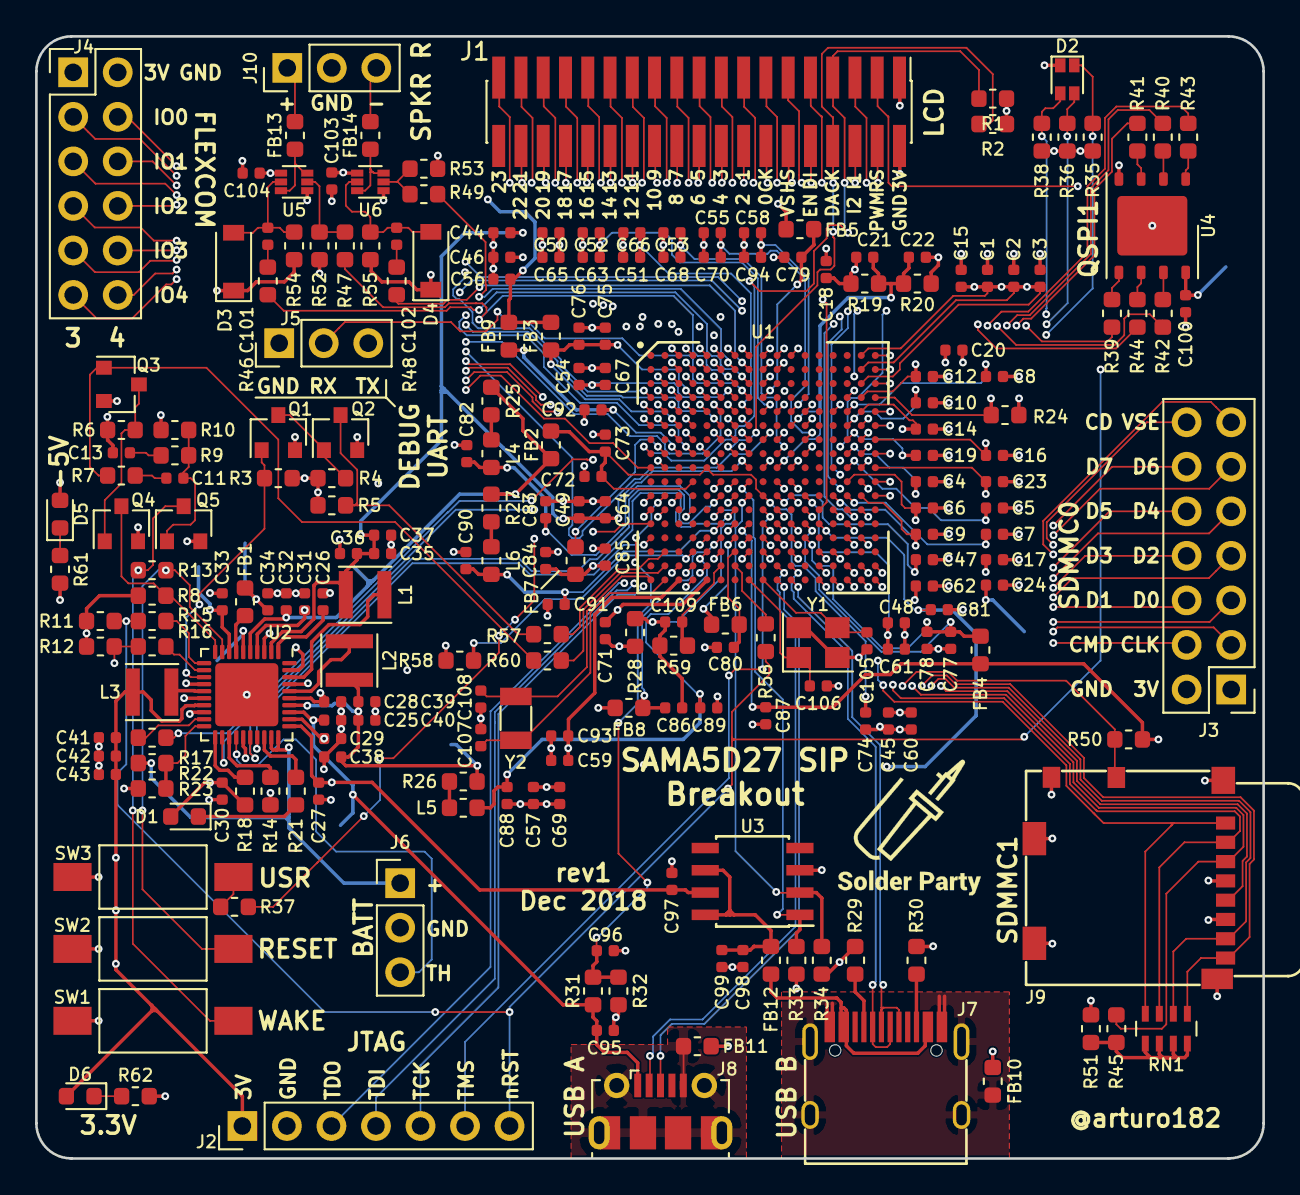
[picture p11: board sama5d27c_breakout.kicad_pcb from above]

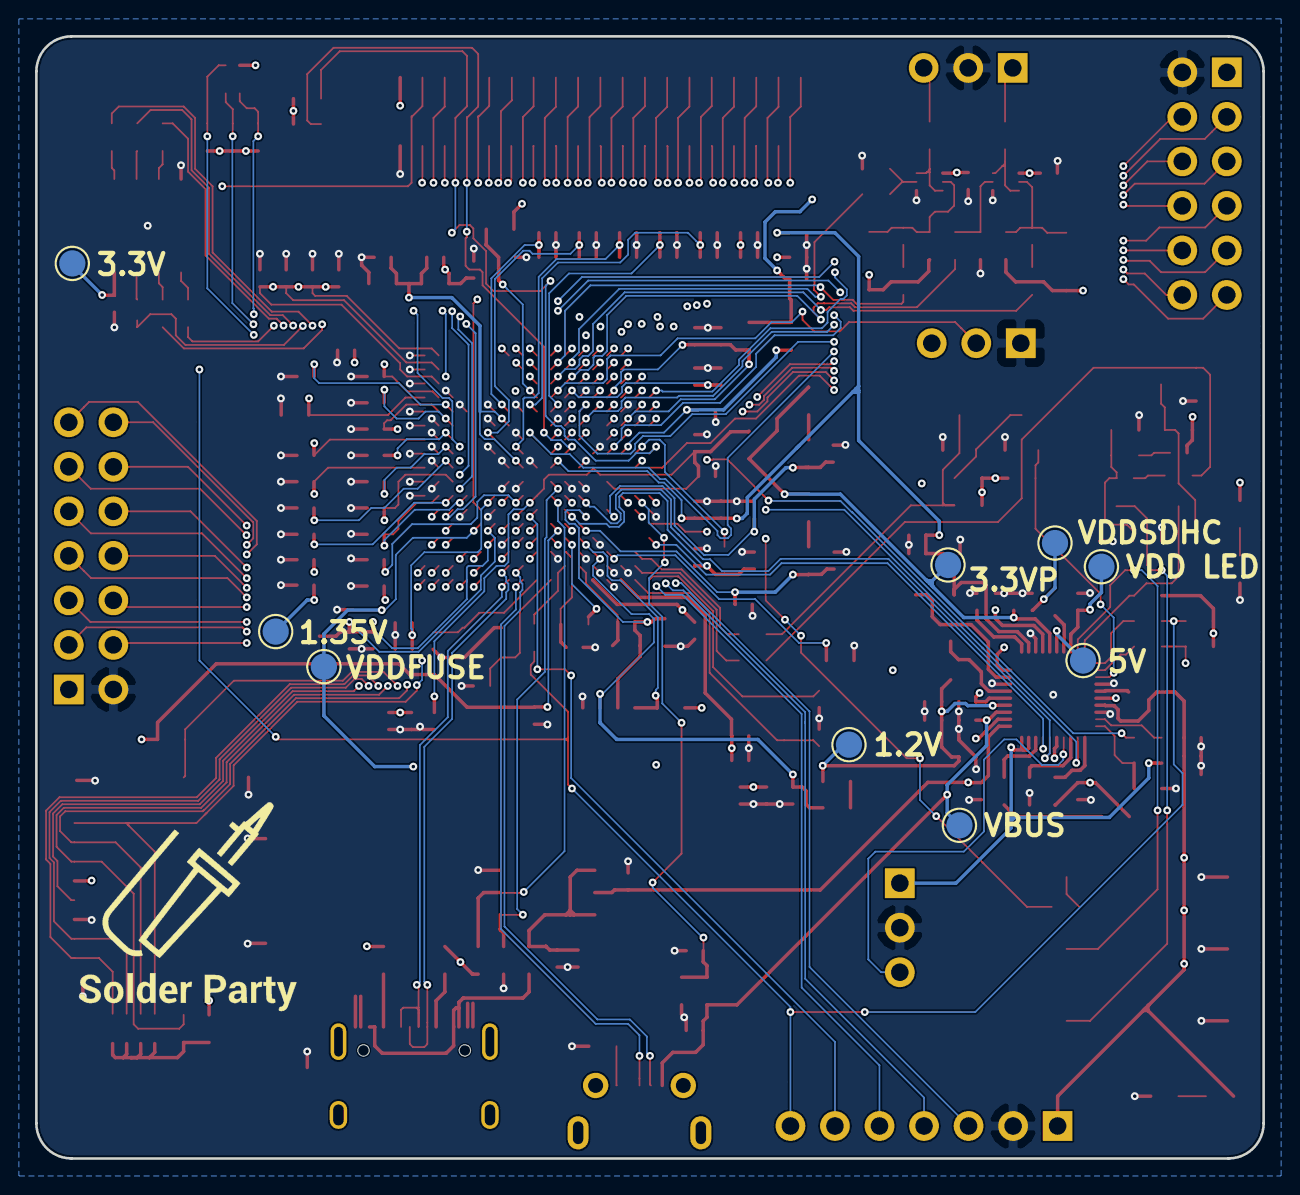
[picture p12: board sama5d27c_breakout.kicad_pcb from below]

Board: 4 copper layers, 70.0 x 64.0 mm, 233 parts (9 on the bottom side), 184 nets.
