arturo182/sama5d27c_breakout/(commit log)

2018-11-25 Initial WIP import
    [power.sch, sama5d27c_breakout.kicad_pcb, sama5d27c_breakout.sch]
2018-11-26 Connected Unit F
    [power.sch, sama5d27c_breakout.sch]
2018-11-28 Added QSPI Flash and started work on PMIC
    [misc.sch, power.sch, sama5d27c_breakout.sch]
2018-11-29 Finished power, added microSD, USB A, btn
    [misc.sch, power.sch, sama5d27c_breakout.sch]
2018-11-30 Finish schematic (?), set footprints and start placement
    [misc.sch, peripherals.sch, power.sch, sama5d27c_breakout.kicad_pcb, sama5d27c_breakout.sch, usb.sch]
2018-12-01 Added a few 3D models
    [sama5d27c_breakout.kicad_pcb]
2018-12-01 Even more 3d models
    [sama5d27c_breakout.kicad_pcb]
2018-12-02 Start the routing
    [peripherals.sch, sama5d27c_breakout.kicad_pcb, usb.sch]
2018-12-02 Route more power traces
    [sama5d27c_breakout.kicad_pcb]
2018-12-03 More routing, 165 unconnected left
    [misc.sch, peripherals.sch, power.sch, sama5d27c_breakout.kicad_pcb, usb.sch]
2018-12-03 Fix USB bug by updating symbols lib
    [peripherals.sch, sama5d27c_breakout.kicad_pcb, usb.sch]
2018-12-04 Almost routed, just 2 unconnected left
    Hahahahahah HahahaHhahaHAHAhahahHAHAHAHhahah
    [power.sch, sama5d27c_breakout.kicad_pcb, sama5d27c_breakout.sch, usb.sch]
2018-12-05 Finish the routing, add bom, schematic
    [power.sch, sama5d27c_breakout.kicad_pcb]
